ttomasini/raspizero_gpib_shield/Case/Gehaeuse_V4.FCStd

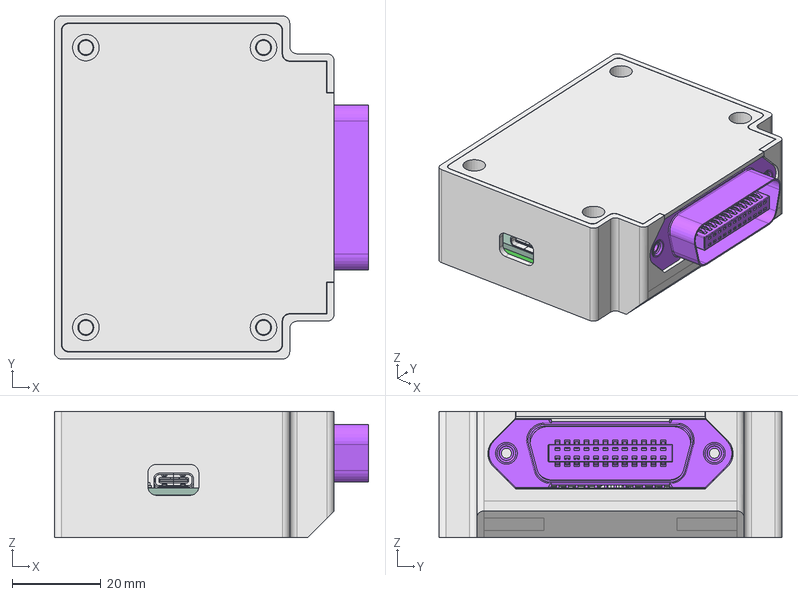
[picture p4: CAD file, 2024-04-14]
Case/Gehaeuse_V4.FCStd
70.8 x 77.2 x 28.4 mm
CaseBottom
CaseLid
R_Array_SIP017
LED_0805_2012Metric004
R_0805_2012Metric040
R_0805_2012Metric042
R_0805_2012Metric044
R_0805_2012Metric046
C_0805_2012Metric006
R_0805_2012Metric048
Fuse_0805_2012Metric002
USB_C_Receptacle_GCT_USB4125-xx-x_6P_TopMnt_Horizontal017
USB_C_Receptacle_GCT_USB4125-xx-x_6P_TopMnt_Horizontal018
USB_C_Receptacle_GCT_USB4125-xx-x_6P_TopMnt_Horizontal019
USB_C_Receptacle_GCT_USB4125-xx-x_6P_TopMnt_Horizontal020
USB_C_Receptacle_GCT_USB4125-xx-x_6P_TopMnt_Horizontal021
USB_C_Receptacle_GCT_USB4125-xx-x_6P_TopMnt_Horizontal022
USB_C_Receptacle_GCT_USB4125-xx-x_6P_TopMnt_Horizontal023
USB_C_Receptacle_GCT_USB4125-xx-x_6P_TopMnt_Horizontal024
USB_C_Receptacle_GCT_USB4125-xx-x_6P_TopMnt_Horizontal025
USB_C_Receptacle_GCT_USB4125-xx-x_6P_TopMnt_Horizontal026
USB_C_Receptacle_GCT_USB4125-xx-x_6P_TopMnt_Horizontal027
USB_C_Receptacle_GCT_USB4125-xx-x_6P_TopMnt_Horizontal028
USB_C_Receptacle_GCT_USB4125-xx-x_6P_TopMnt_Horizontal029
USB_C_Receptacle_GCT_USB4125-xx-x_6P_TopMnt_Horizontal030
USB_C_Receptacle_GCT_USB4125-xx-x_6P_TopMnt_Horizontal031
USB_C_Receptacle_GCT_USB4125-xx-x_6P_TopMnt_Horizontal032
R_0805_2012Metric050
R_0805_2012Metric052
C_0805_2012Metric008
R_0805_2012Metric054
R_0805_2012Metric056
R_0805_2012Metric058
R_0805_2012Metric060
R_0805_2012Metric062
R_0805_2012Metric064
SOT_23
R_Array_SIP019
R_0805_2012Metric066
Raspberry Pi Zero 2 W269
Raspberry Pi Zero 2 W270
Raspberry Pi Zero 2 W271
Raspberry Pi Zero 2 W272
Raspberry Pi Zero 2 W273
Raspberry Pi Zero 2 W274
Raspberry Pi Zero 2 W275
Raspberry Pi Zero 2 W276
Raspberry Pi Zero 2 W277
Raspberry Pi Zero 2 W278
Raspberry Pi Zero 2 W279
Raspberry Pi Zero 2 W280
Raspberry Pi Zero 2 W281
Raspberry Pi Zero 2 W282
Raspberry Pi Zero 2 W283
Raspberry Pi Zero 2 W284
Raspberry Pi Zero 2 W285
Raspberry Pi Zero 2 W286
Raspberry Pi Zero 2 W287
Raspberry Pi Zero 2 W288
Raspberry Pi Zero 2 W289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
