ttomasini/raspizero_gpib_shield/Footprints/112-024-113R001_colored.FCStd

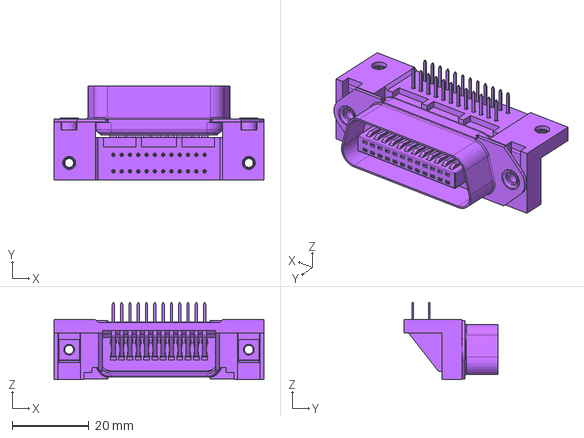
[picture p5: CAD file, 2024-03-08]
Footprints/112-024-113R001_colored.FCStd
54.7 x 24.4 x 20.1 mm
