ttomasini/raspizero_gpib_shield/Case/Gehaeuse_V4_-_CaseBottom.step

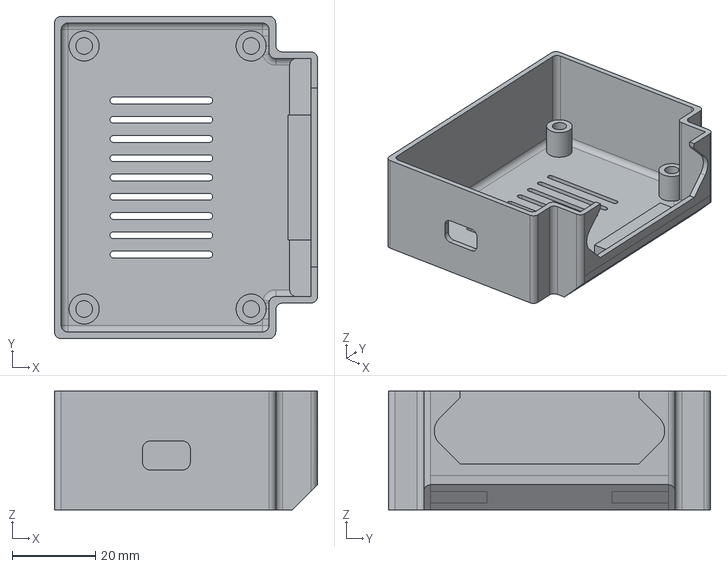
[picture p6: CAD file, 2024-04-14]
Case/Gehaeuse_V4_-_CaseBottom.step
63.0 x 77.2 x 28.4 mm
