ttomasini/raspizero_gpib_shield/Case/Gehaeuse_V4_-_CaseLid.step

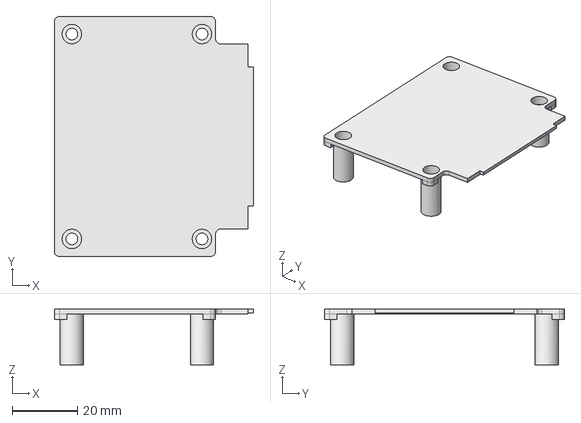
[picture p7: CAD file, 2024-04-14]
Case/Gehaeuse_V4_-_CaseLid.step
61.3 x 73.8 x 17.2 mm
