ttomasini/raspizero_gpib_shield/Case/Gehaeuse_V4_-_RaspberrySpacer.step

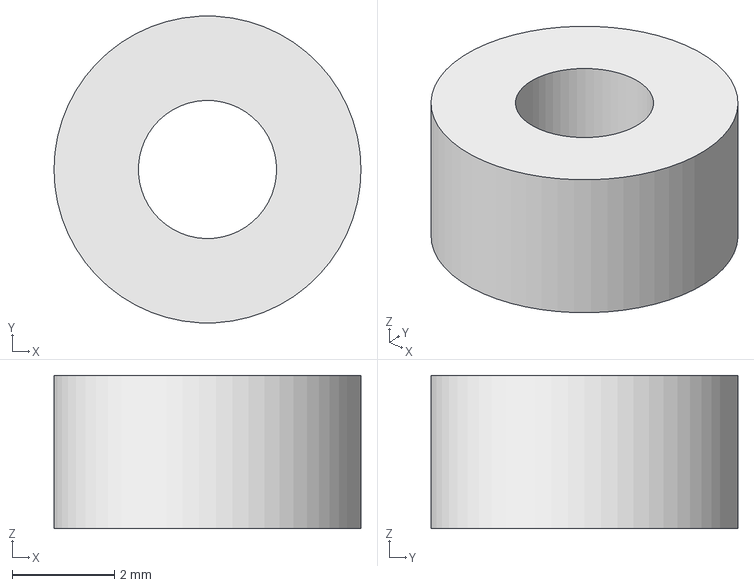
[picture p8: CAD file, 2024-04-14]
Case/Gehaeuse_V4_-_RaspberrySpacer.step
6.00 x 5.99 x 3.00 mm
