ttomasini/raspizero_gpib_shield/Case/Gehaeuse_V3.FCStd

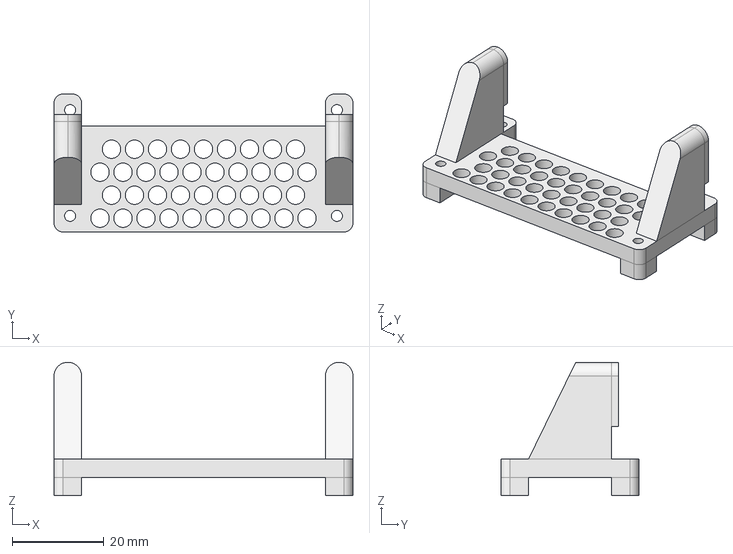
[picture p9: CAD file, 2024-02-24, an earlier design]
Case/Gehaeuse_V3.FCStd
65.0 x 30.0 x 29.0 mm
