ttomasini/raspizero_gpib_shield/(list of files, cad)

Other CAD files:
Case/Gehaeuse V3.stl
