ttomasini/raspizero_gpib_shield/Documentation/RaspiZero_GPIB_v7_schematic.pdf

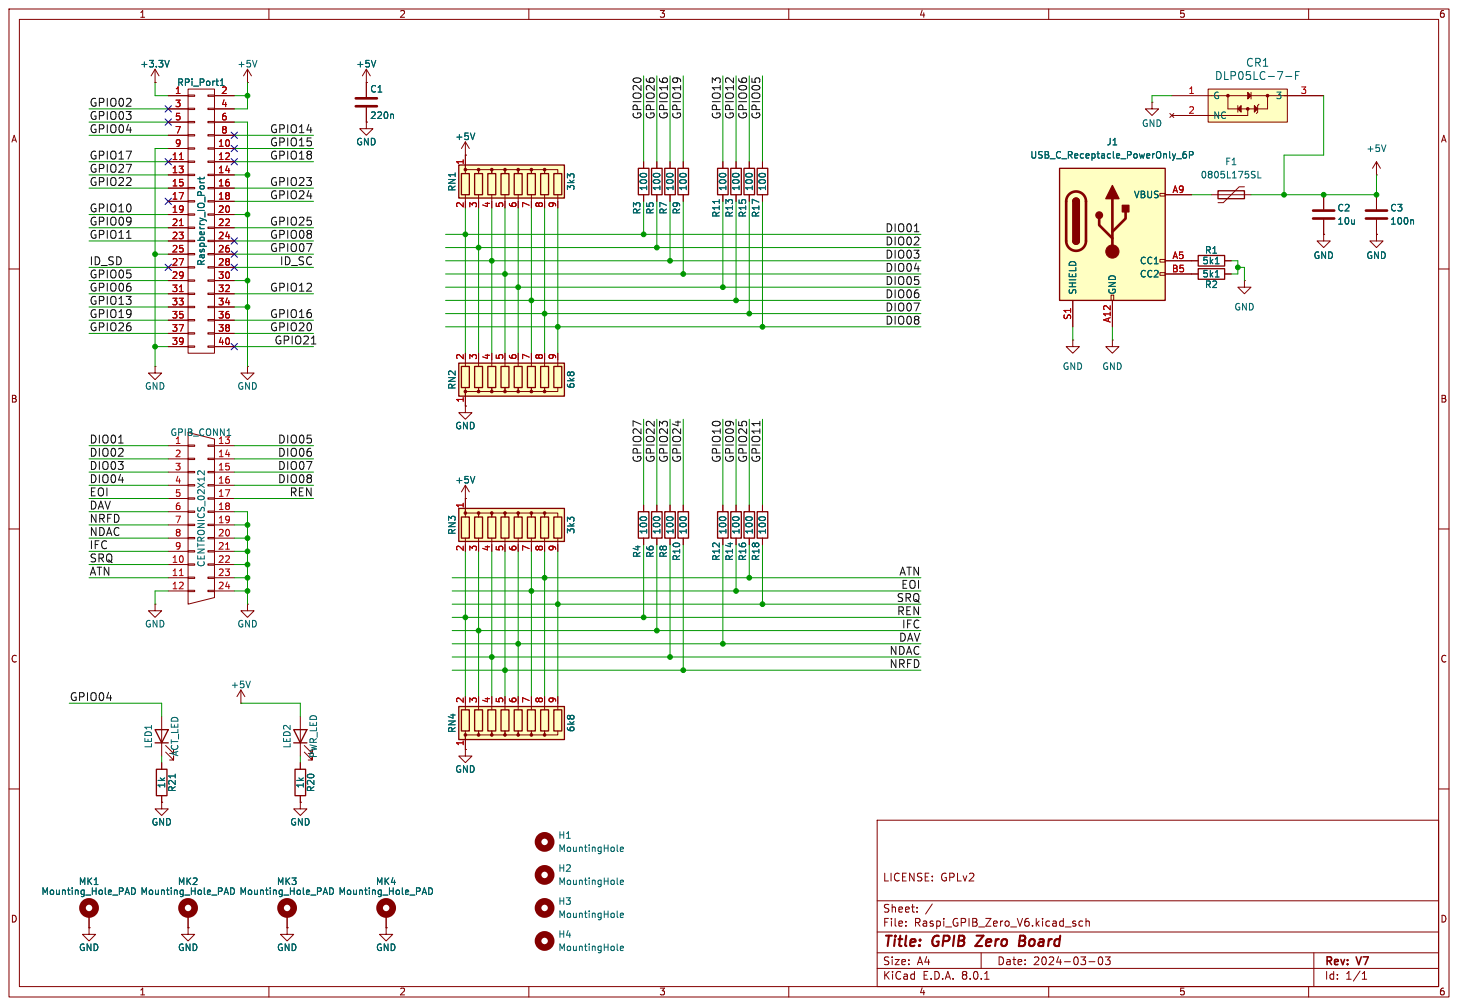
[picture p10: page 1]

Id: 1/1 Title: GPIB Zero Board
