ttomasini/raspizero_gpib_shield/(commit log)

2024-02-24 Convert to KiCad 8 file formats and create PCB
    [Gehaeuse V3.stl, Gehaeuse_V3.FCStd, Raspi_GPIB_Zero_V6.kicad_pcb, Raspi_GPIB_Zero_V6.kicad_sch, Raspi_GPIB_Zero_V6.sch]
2024-02-24 Add PCB picture to README.md and change to relative links
    [Raspi_GPIB_Zero_V6.kicad_pcb]
2024-02-26 Add USB-C power-only connector
    [Raspi_GPIB_Zero_V6.kicad_pcb, Raspi_GPIB_Zero_V6.kicad_sch]
2024-03-03 Add 5V filtering capacitors and polyfuse
    [Raspi_GPIB_Zero_V6.kicad_pcb, Raspi_GPIB_Zero_V6.kicad_sch]
2024-03-03 Add new enclosure as Gehaeuse_V4 and update schematic
    [Gehaeuse_V4_-_CaseBottom.step, Gehaeuse_V4_-_CaseLid.step, Raspi_GPIB_Zero_V6.kicad_pcb, Raspi_GPIB_Zero_V6.kicad_sch]
2024-03-05 Add minor (mostly cosmetic) PCB adjustments and JLCPCB serial location
    [Raspi_GPIB_Zero_V6.kicad_pcb]
2024-03-08 Add correct Centronics IEEE 488 MALE right angle pcb connector
    [112-024-113R001_colored.FCStd, Raspi_GPIB_Zero_V6.kicad_pcb]
2024-03-13 Add TVS diode and fix 3d model for GPIB connector
    [Raspi_GPIB_Zero_V6.kicad_pcb, Raspi_GPIB_Zero_V6.kicad_sch]
2024-03-24 Update schematic pdf and adjust pcb cuts
    [Raspi_GPIB_Zero_V6.kicad_pcb, Raspi_GPIB_Zero_V6.kicad_sch]
2024-03-25 Add narrower housing with cut-outs
    [Gehaeuse_V4.FCStd, Gehaeuse_V4_-_CaseBottom.step, Gehaeuse_V4_-_CaseLid.step, Raspi_GPIB_Zero_V6.kicad_pcb]
2024-04-14 Add spacer for raspberry zero assembly on pcb
    [Gehaeuse_V4_-_RaspberrySpacer.step]
2024-04-14 Modify case for better fit and improved heat dissipation
    [Gehaeuse_V4.FCStd, Gehaeuse_V4_-_CaseBottom.step, Gehaeuse_V4_-_CaseLid.step]
