ttomasini/raspizero_gpib_shield/(notices)

Notices in the files:
Raspi_GPIB_Zero_V6.kicad_sch:
LICENSE: GPLv2
